nullsub/mproc/readme.md

MPROC is a cpu built out of 74xx logic-gates.
