nullsub/mproc/docs/stuff/1bitalu.gif

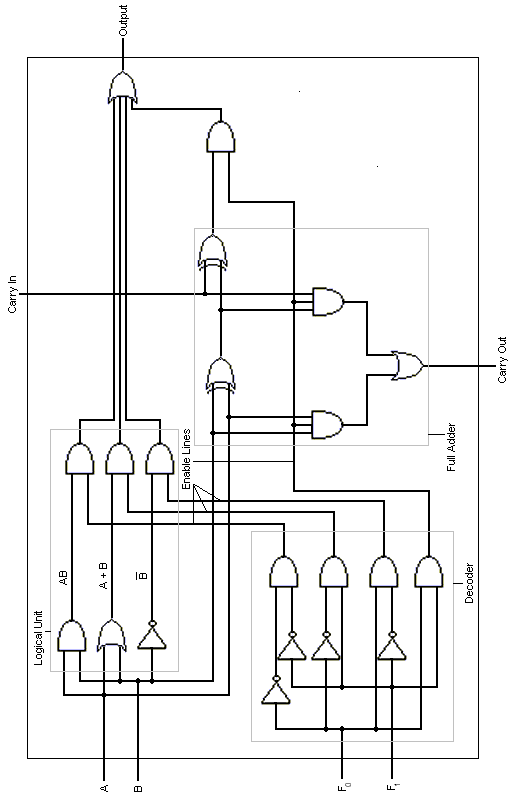
docs/stuff/1bitalu.gif
