nullsub/mproc/docs/stuff/Cse675.02.F.ALUDesign_part1.pdf

# Arithmetic / Logic Unit – ALU Design

### Presentation F

### CSE 675.02: Introduction to Computer Architecture

Reading Assignment: B5, 3.4 | Slides by Gojko Babi

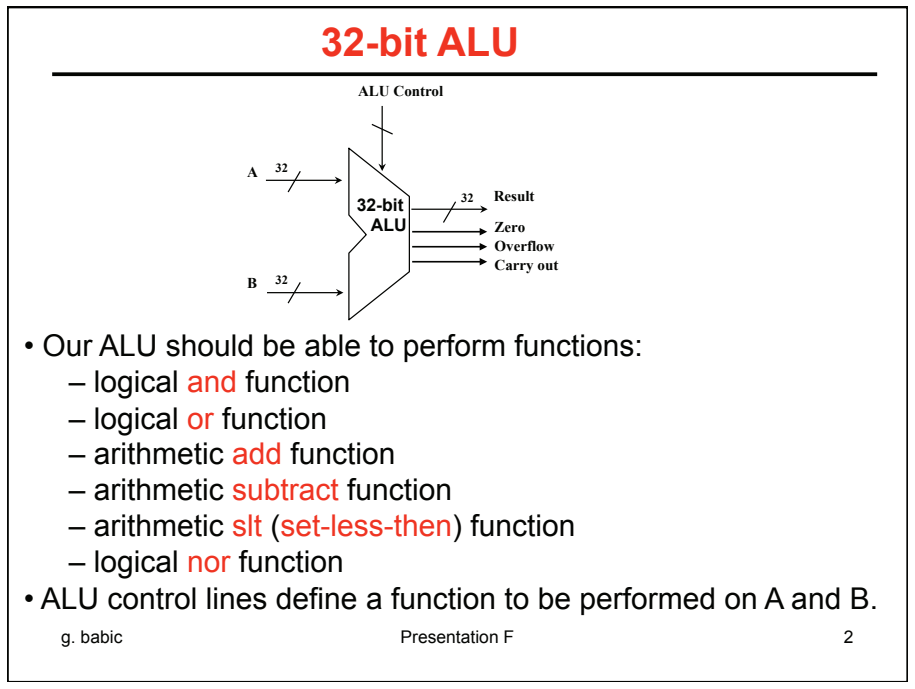
[picture p2: figure]
g. babic; Presentation F; ALU Control; 32 Result; 32-bit ALU; – logical and function – logical or function – arithmetic add function – arithmetic subtract function; – logical nor function; Zero Overflow Carry out

### - Our ALU should be able to perform functions:

### – arithmetic slt (set-less-then) function

- ALU control lines define a function to be performed on A and B.

g. babic | Presentation F | 3

## Functioning of 32-bit ALU

ALU Control

32

32

### 32 Result

A

B

32-bit
ALU | Zero
| Overflow Carry out

ALU Control lines

- Result lines provide result of the chosen function applied to values of A and B
- Since this ALU operates on 32-bit operands, it is called 32-bit ALU
- Zero output indicates if all Result lines have value 0
- Overflow indicates integer overflow of add and subtract functions;
for unsigned integers, this overflow indicator does not provide any useful information
- Carry out indicates carry out and unsigned integer overflow

4
Function | Ainvert | Binvert | Operation
and | 0 | 0 | 00
or | 0 | 0 | 01
add | 0 | 0 | 10
subtract | 0 | 1 | 10
slt | 0 | 1 | 11
nor | 1 | 1 | 00

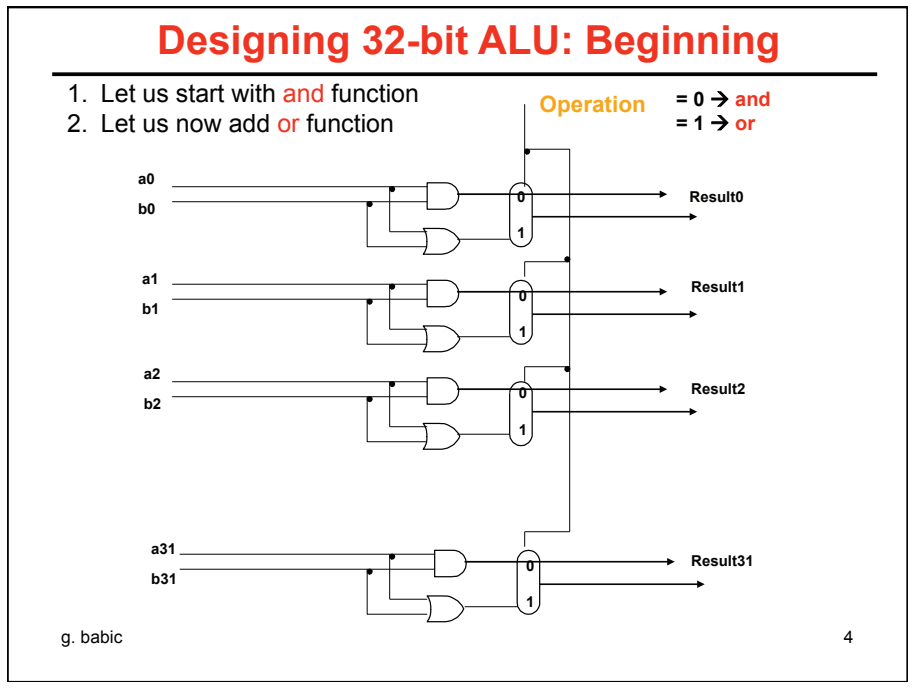
[picture p3: figure]
g. babic; Designing 32-bit ALU: Beginning; Result0; Result1; Result2; Result31; 1. Let us start with and function 2. Let us now add or function; Operation; and

## Designing 32-bit ALU: Principles

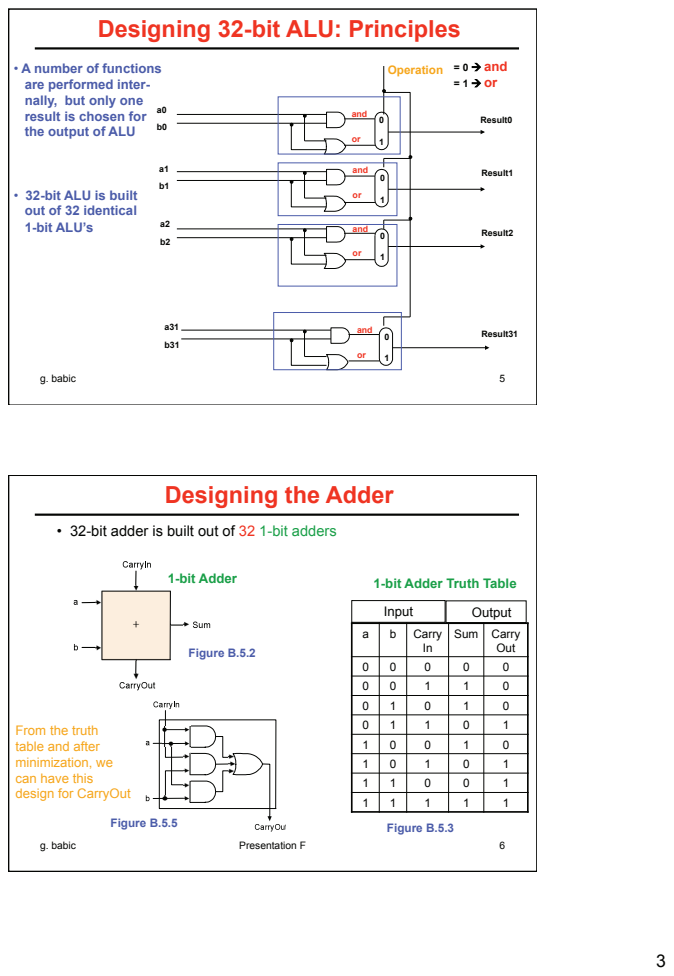
[picture p4: page 3]
g. babic; Result0; Result1; Result2; Result31; • A number of functions; Operation; and; Presentation F; Input; Output; Figure B.5.2; Figure B.5.5; Figure B.5.3

are performed inter-
nally, but only one
result is chosen for
the output of ALU

• 32-bit ALU is built
out of 32 identical
1-bit ALU’s

Designing the Adder

• 32-bit adder is built out of 32 1-bit adders

1-bit Adder Truth Table 1-bit Adder

a | b | Carry In | Sum | Carry Out

From the truth
table and after
minimization, we
can have this
design for CarryOut

## 32-bit Adder

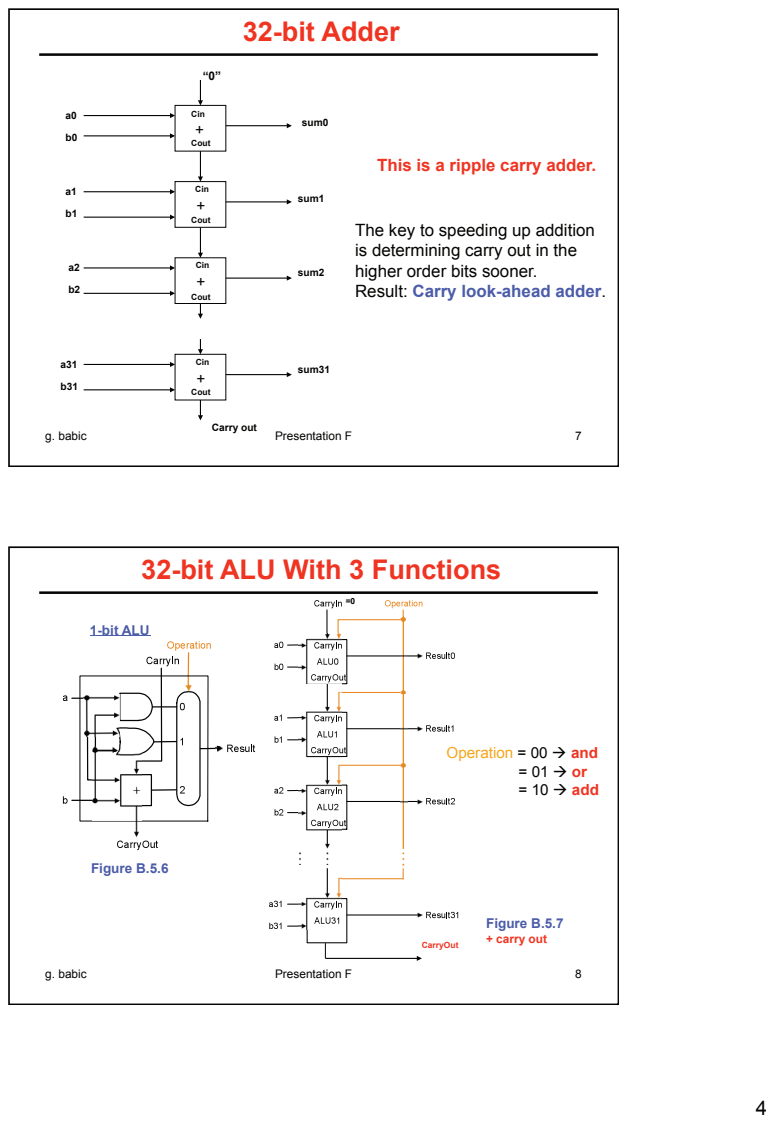
[picture p5: page 4]
g. babic; Presentation F; sum0; sum31; sum2; sum1; Cout; Cin; Carry out; 1-bit ALU; CarryOut; Operation = 00 -; and; add; Figure B.5.6; Figure B.5.7 + carry out

This is a ripple carry adder.

The key to speeding up addition
is determining carry out in the
higher order bits sooner.
Result: Carry look-ahead adder.

32-bit ALU With 3 Functions

## 32-bit Subtractor

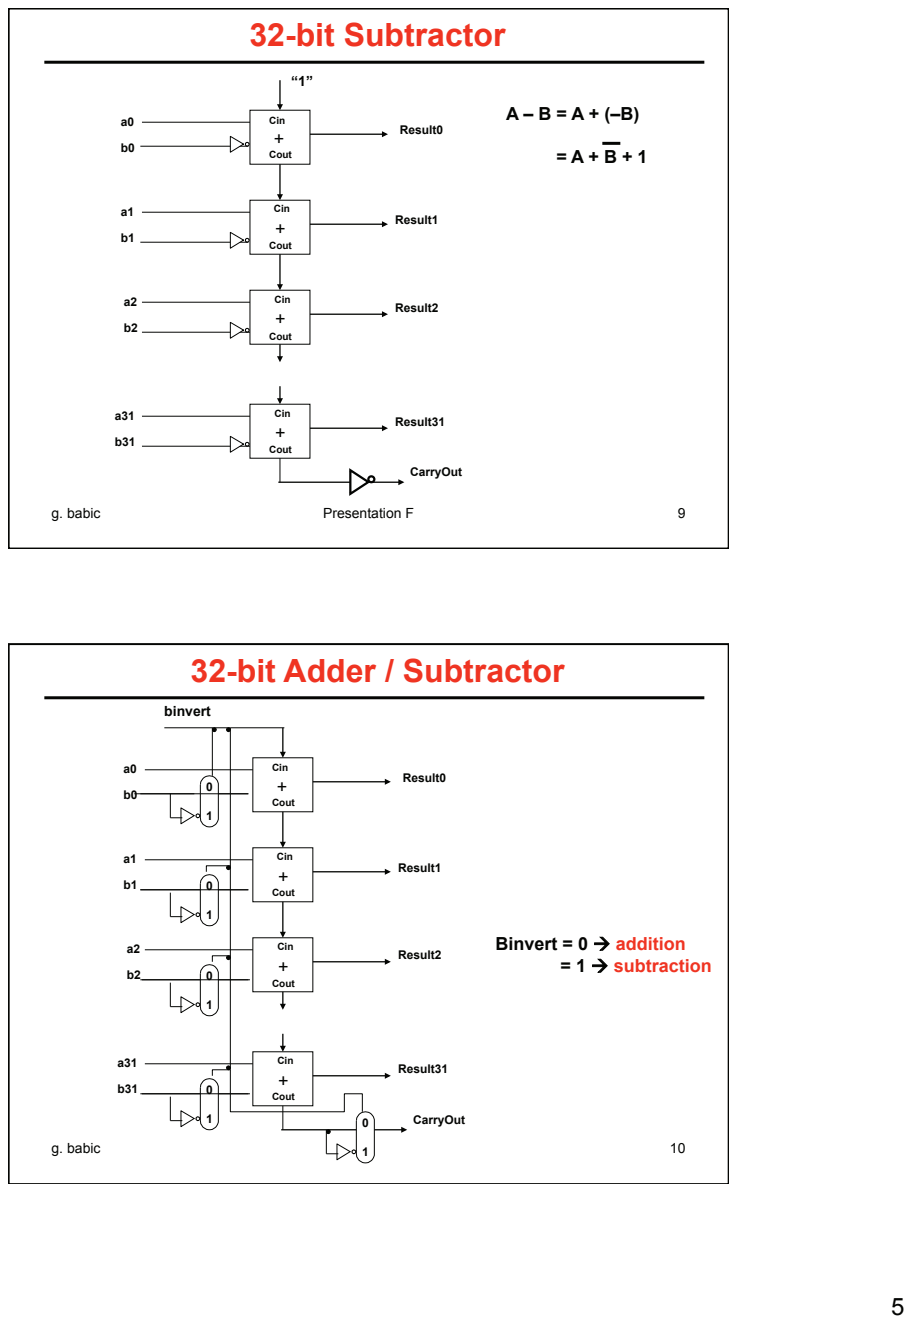
[picture p6: page 5]
g. babic; Presentation F; Result0; Result31; Result2; Result1; Cout; Cin; CarryOut; binvert; Binvert = 0 -; addition; subtraction

32-bit Adder / Subtractor

## 32-bit ALU With 4 Functions

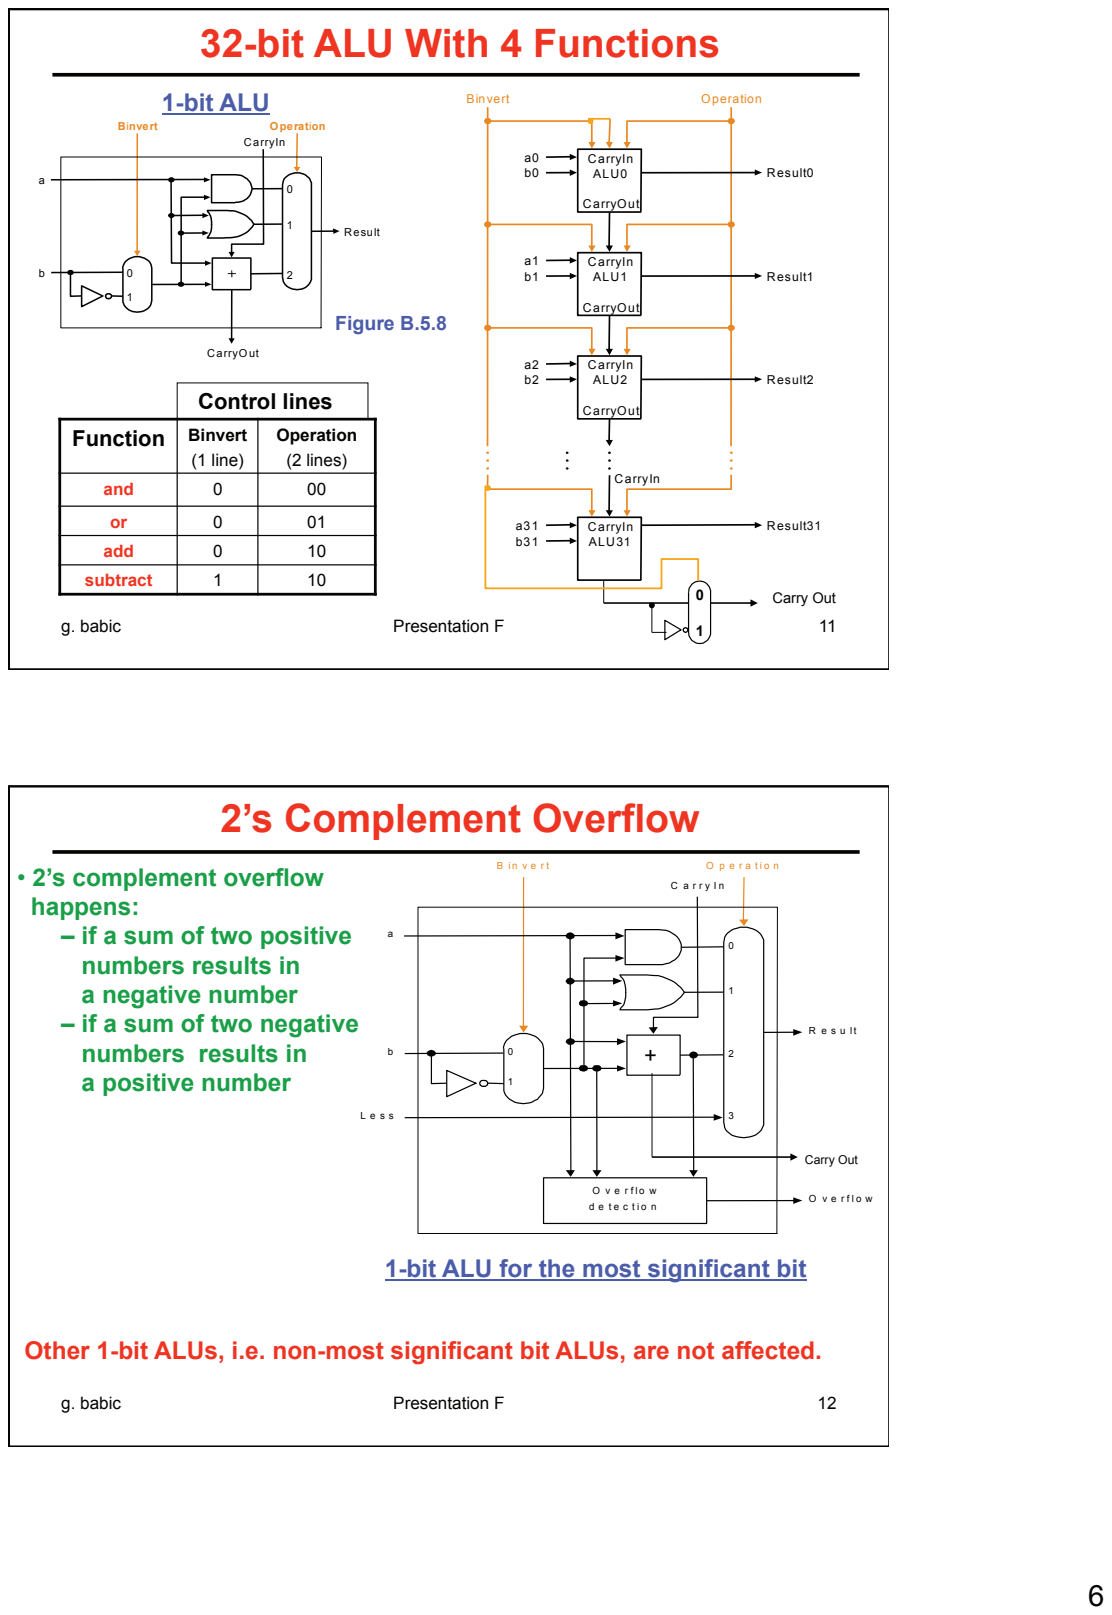
[picture p7: page 6]
g. babic; Presentation F; Control lines; 1-bit ALU; Carry Out; ALU0; Result0; Result1; Result2; Operation; Result31; Binvert; CarryIn; CarryOut; ALU1; ALU2; ALU31; Result; Figure B.5.8; 2’s Complement Overflow

Function | Binvert (1 line) | Operation (2 lines)

and | 0 | 00

or | 0 | 01
add | 0 | 10
subtract | 1 | 10

• 2’s complement overflow
happens:
– if a sum of two positive
numbers results in
a negative number
– if a sum of two negative
a positive number

1-bit ALU for the most significant bit

Other 1-bit ALUs, i.e. non-most significant bit ALUs, are not affected.

## 32-bit ALU With 4 Functions and Overflow

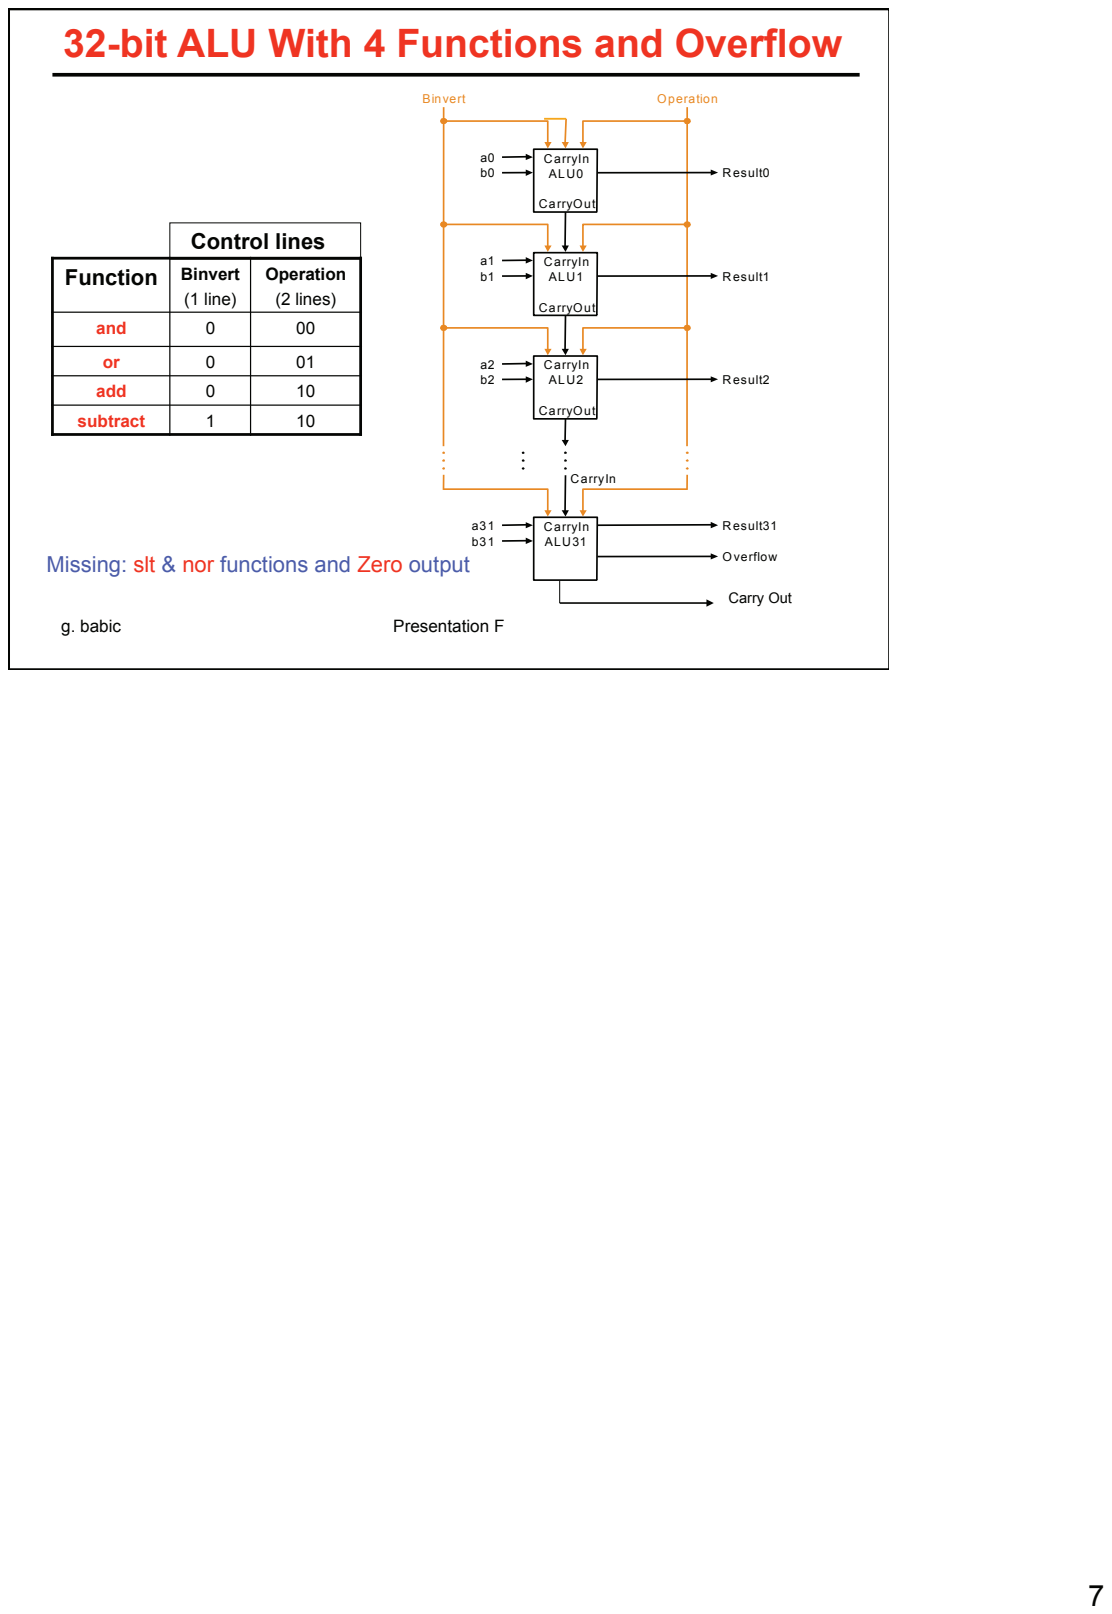
[picture p8: page 7]
g. babic; Presentation F; Carry Out; ALU0; Result0; Result1; Result2; Operation; Result31; Overflow; Binvert; CarryIn; CarryOut; ALU1; ALU2; ALU31; Control lines

Function | Binvert (1 line) | Operation (2 lines)

and | 0 | 00

or | 0 | 01
add | 0 | 10
subtract | 1 | 10

Missing: slt & nor functions and Zero output
