nullsub/mproc/schematics/IO_Board/io_board.brd

## EAGLE design schematics/IO_Board/io_board.brd (2019-09-12)

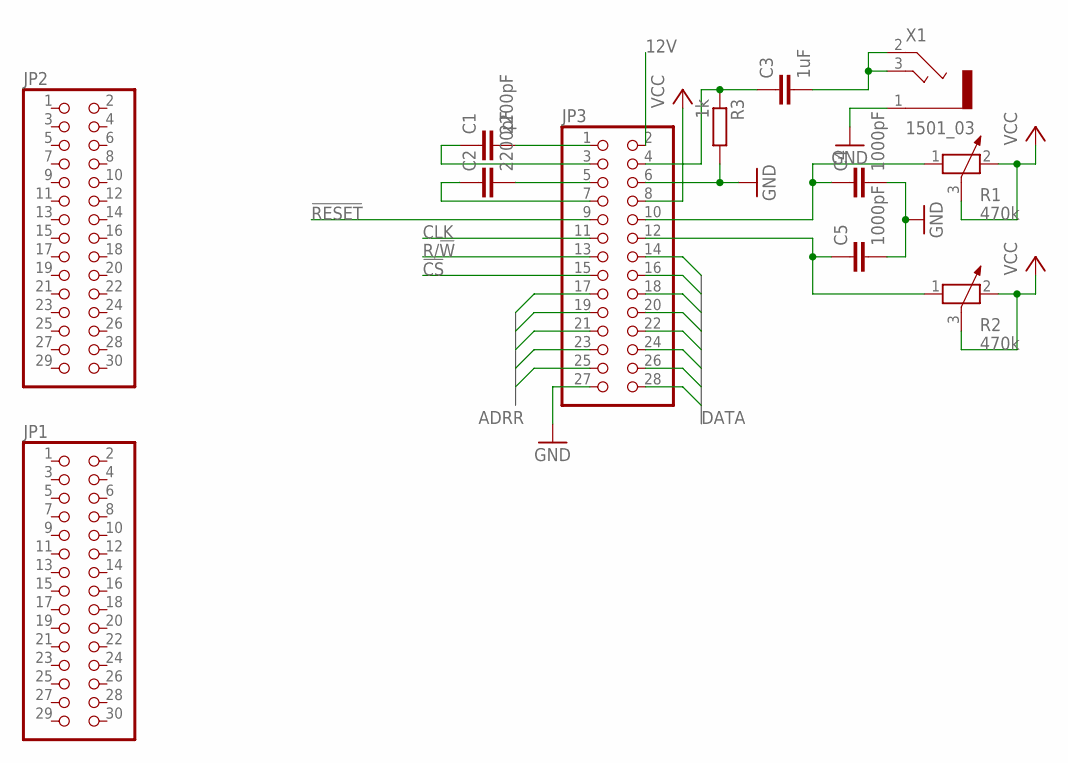
[picture p9: schematic io_board.sch]

Parts:
C1, C2: 2200pF; C1206
C3: 1uF; C1206
C4, C5: 1000pF; C1206
JP1, JP2: PINHD-2X15; 2X15
JP3: PINHD-2X14; 2X14
R1, R2: 470k; PT-10
R3: 1k; R0805
X1: 1501_03

Connections:
12V: JP3.2
!CS: JP3.15
!RESET: JP3.9
CLK: JP3.11
GND: C4.2, C5.2, JP3.6, JP3.27, R3.2, X1.1
unnamed: C4.1, JP3.10, R1.1
unnamed: C1.2, JP3.1
unnamed: C1.1, JP3.3
unnamed: C5.1, JP3.12, R2.1
unnamed: C2.2, JP3.5
unnamed: C2.1, JP3.7
unnamed: C3.2, X1.2, X1.3
unnamed: C3.1, JP3.4, R3.1
R/!W: JP3.13
VCC: JP3.8, R1.2, R1.3, R2.2, R2.3

Board: 2 copper layers, 12 parts (0 on the bottom side), 10 nets, no tracks yet.
