nullsub/mproc/schematics/UI_board/ui_board.brd

## EAGLE design schematics/UI_board/ui_board.brd (2014-05-11)

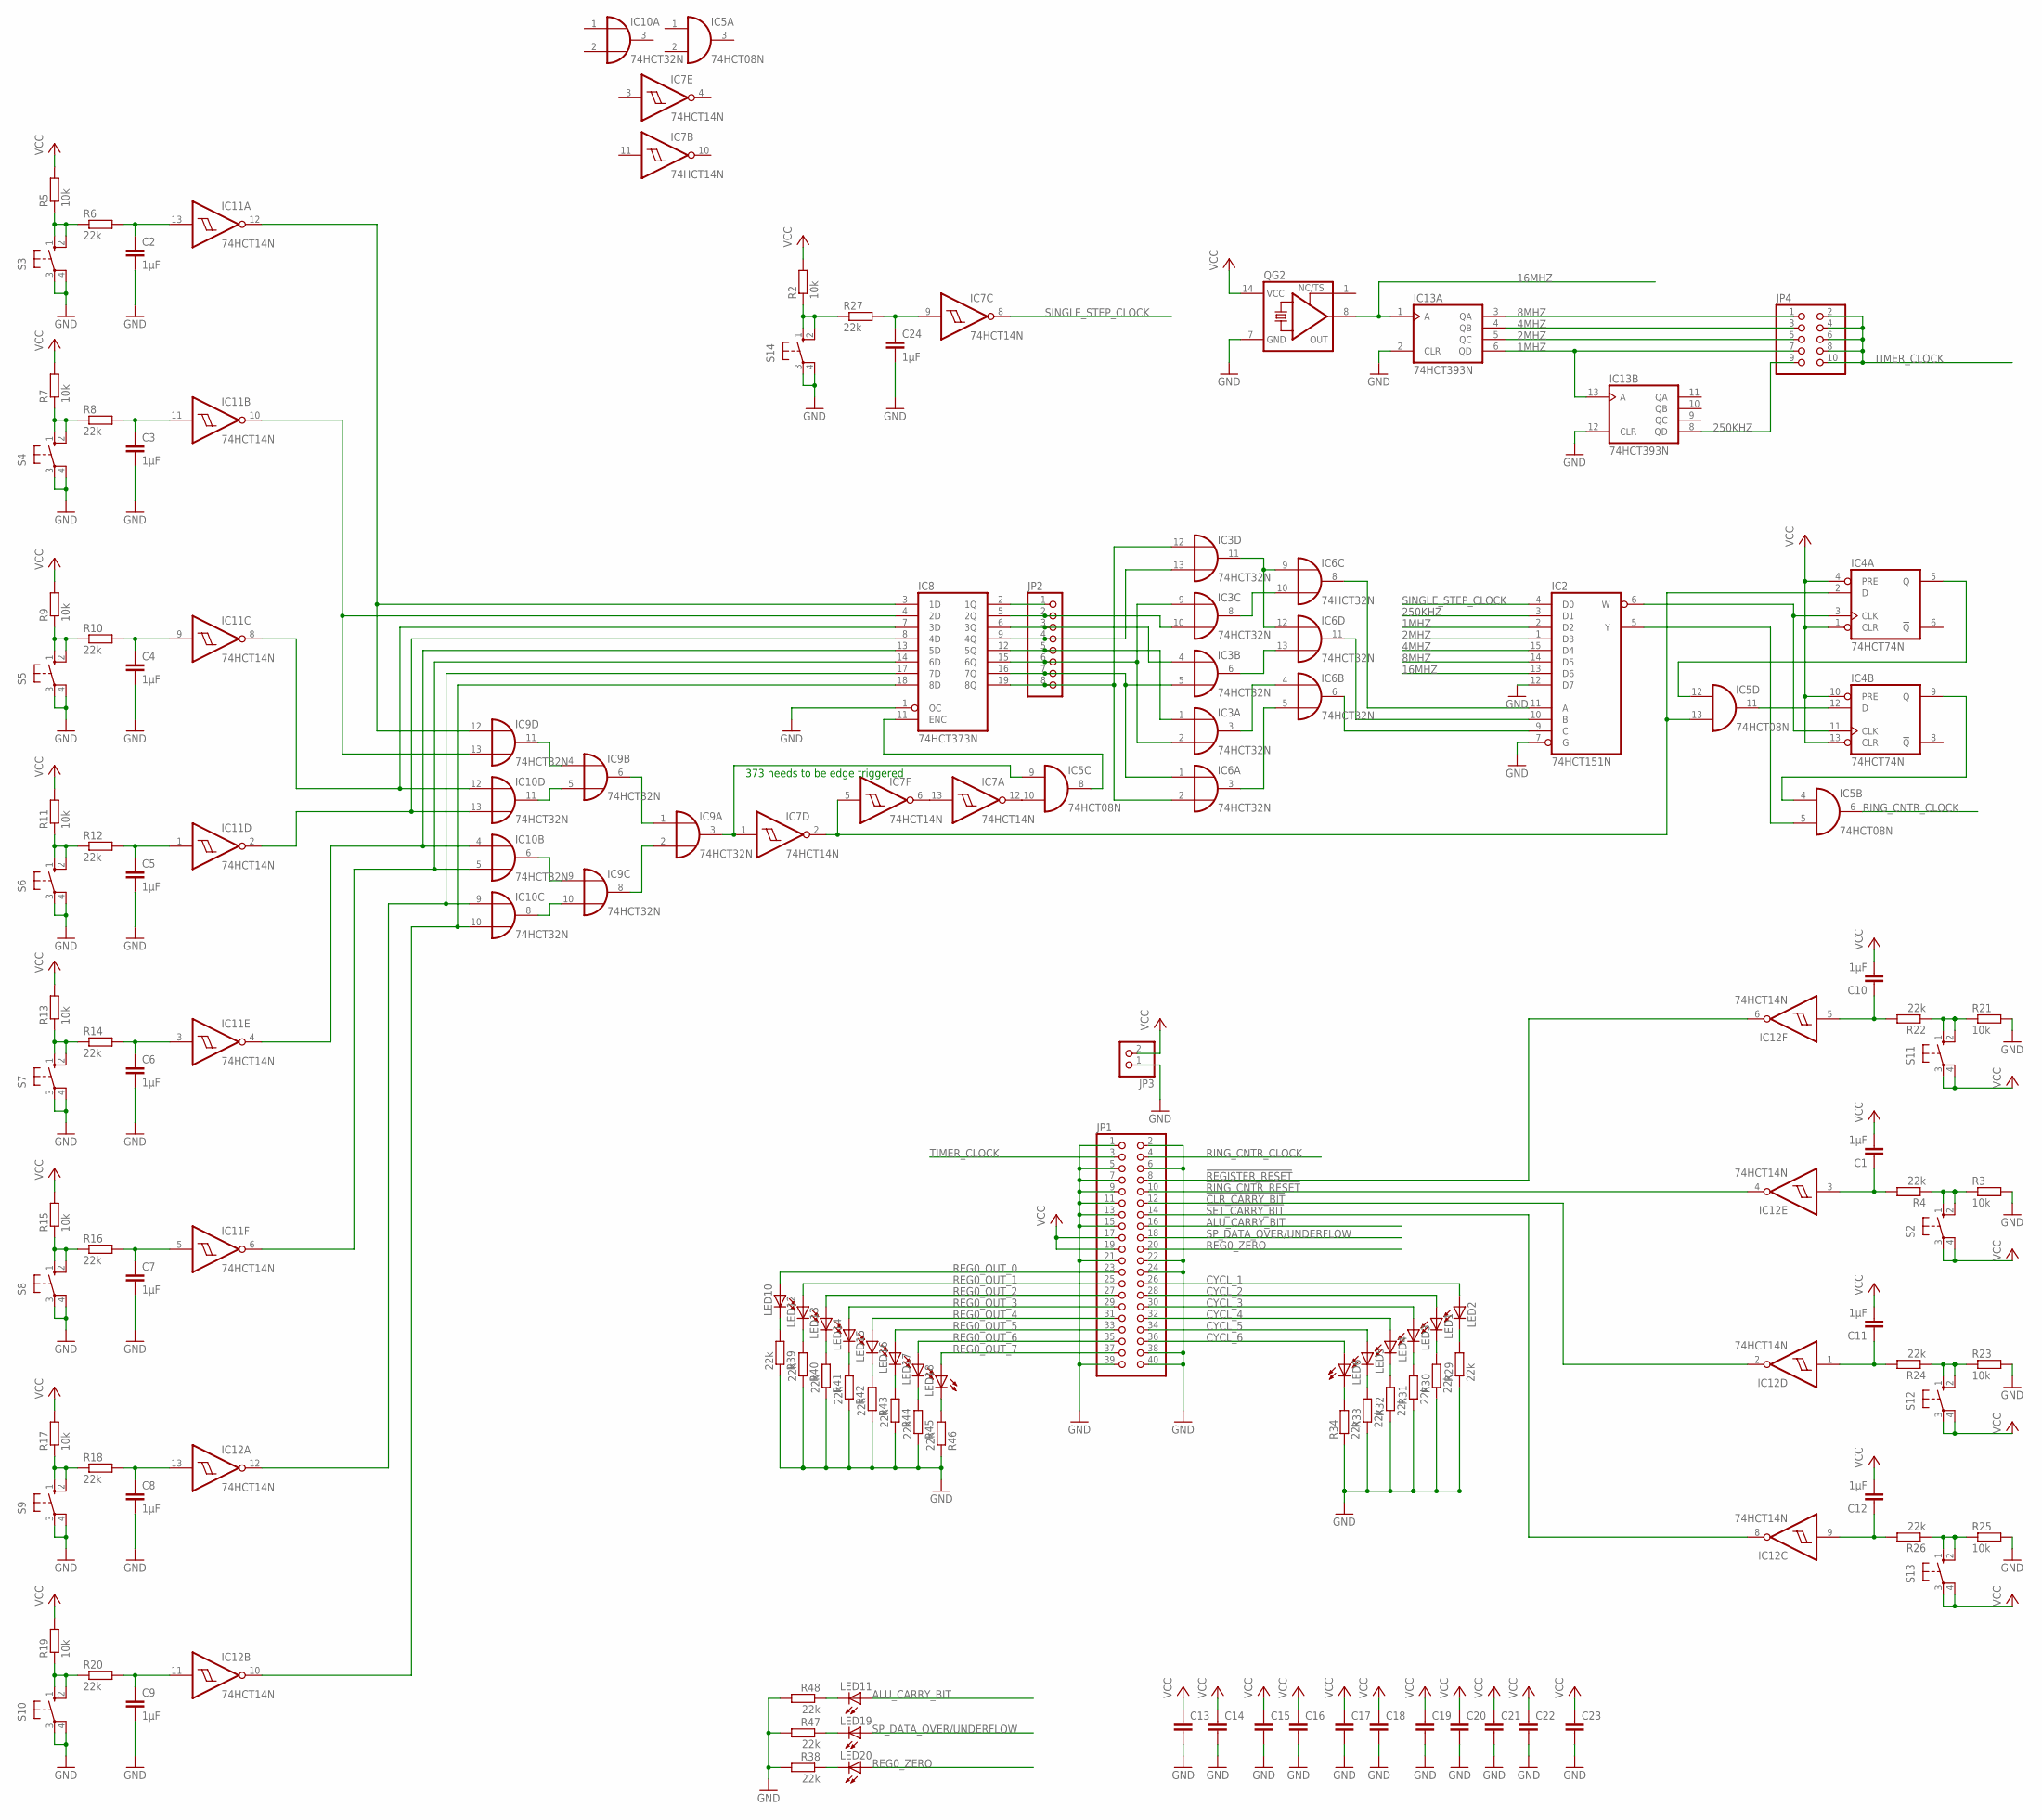
[picture p10: schematic ui_board.sch]

Parts:
C1, C2, C3, C4, C5, C6, C7, C8, C9, C10, C11, C12, C24: 1µF; C025-024X044
C13, C14, C15, C16, C17, C18, C19, C20, C21, C22, C23: C-EUC1206; C1206
IC2: 74HCT151N; DIL16
IC3, IC6, IC9, IC10: 74HCT32N; DIL14
IC4: 74HCT74N; DIL14
IC5: 74HCT08N; DIL14
IC7, IC11, IC12: 74HCT14N; DIL14
IC8: 74HCT373N; DIL20
IC13: 74HCT393N; DIL14
JP1: PINHD-2X20; 2X20
JP2: PINHD-1X8; 1X08
JP3: PINHD-1X2; 1X02
JP4: PINHD-2X5; 2X05
LED1, LED2, LED3, LED4, LED5, LED6, LED10, LED11, LED12, LED13, LED14, LED15, LED16, LED17, LED18, LED19, LED20: LED3MM
QG2: XO-14; DIL14S
R2, R3, R5, R7, R9, R11, R13, R15, R17, R19, R21, R23, R25: 10k; R1206
R4, R6, R8, R10, R12, R14, R16, R18, R20, R22, R24, R26, R27, R29, R30, R31, R32, R33, R34, R38, R39, R40, R41, R42, R43, R44, R45, R46, R47, R48: 22k; R1206
S2, S3, S4, S5, S6, S7, S8, S9, S10, S11, S12, S13, S14: 10-XX; B3F-10XX

Connections:
1MHZ: IC2.2 (D2), IC13.6 (QD), IC13.13 (A), JP4.7
2MHZ: IC2.1 (D3), IC13.5 (QC), JP4.5
4MHZ: IC2.15 (D4), IC13.4 (QB), JP4.3
8MHZ: IC2.14 (D5), IC13.3 (QA), JP4.1
16MHZ: IC2.13 (D6), IC13.1 (A), QG2.8 (OUT)
250KHZ: IC2.3 (D1), IC13.8 (QD), JP4.9
!CLR_CARRY_BIT: IC12.2 (O), JP1.12
!REGISTER_RESET: IC12.6 (O), JP1.8
!RING_CNTR_RESET: IC12.4 (O), JP1.10
!SET_CARRY_BIT: IC12.8 (O), JP1.14
ALU_CARRY_BIT: JP1.16, LED11.A
CHANGE_CLOCK_SELECT: IC5.9 (I0), IC7.1 (I), IC9.3 (O)
CHANGE_CLOCK_SELECT1: IC8.3 (1D), IC9.12 (I0), IC11.12 (O)
CHANGE_CLOCK_SELECT2: IC8.4 (2D), IC9.13 (I1), IC11.10 (O)
CHANGE_CLOCK_SELECT3: IC8.7 (3D), IC10.12 (I0), IC11.8 (O)
CHANGE_CLOCK_SELECT5: IC8.13 (5D), IC10.4 (I0), IC11.4 (O)
CHANGE_CLOCK_SELECT6: IC8.14 (6D), IC10.5 (I1), IC11.6 (O)
CHANGE_CLOCK_SELECT7: IC8.17 (7D), IC10.9 (I0), IC12.12 (O)
CHANGE_CLOCK_SELECT8: IC8.18 (8D), IC10.10 (I1), IC12.10 (O)
CYCL_1: JP1.26, LED2.A
CYCL_2: JP1.28, LED1.A
CYCL_3: JP1.30, LED3.A
CYCL_4: JP1.32, LED4.A
CYCL_5: JP1.34, LED5.A
CYCL_6: JP1.36, LED6.A
GND: C2.2, C3.2, C4.2, C5.2, C6.2, C7.2, C8.2, C9.2, C13.2, C14.2, C15.2, C16.2, C17.2, C18.2, C19.2, C20.2, C21.2, C22.2, C23.2, C24.2, IC2.7 (G), IC2.8 (GND), IC2.12 (D7), IC3.7 (GND), IC4.7 (GND), IC5.7 (GND), IC6.7 (GND), IC7.7 (GND), IC8.1 (OC), IC8.10 (GND), IC9.7 (GND), IC10.7 (GND), IC11.7 (GND), IC12.7 (GND), IC13.2 (CLR), IC13.7 (GND), IC13.12 (CLR), JP1.1, JP1.2, JP1.5, JP1.6, JP1.7, JP1.9, JP1.11, JP1.13, JP1.15, JP1.21, JP1.22, JP1.24, JP1.38, JP1.39, JP1.40, JP3.1, QG2.7 (GND), R3.2, R21.2, R23.2, R25.2, R29.1, R30.1, R31.1, R32.1, R33.1, R34.1, R38.2, R39.1, R40.1, R41.1, R42.1, R43.1, R44.1, R45.1, R46.1, R47.2, R48.2, S3.3, S3.4 (P1), S4.3, S4.4 (P1), S5.3, S5.4 (P1), S6.3, S6.4 (P1), S7.3, S7.4 (P1), S8.3, S8.4 (P1), S9.3, S9.4 (P1), S10.3, S10.4 (P1), S14.3, S14.4 (P1)
unnamed: IC4.9 (Q), IC5.4 (I0)
unnamed: R2.1, R27.1, S14.1 (S), S14.2 (S1)
unnamed: IC4.12 (D), IC5.11 (O)
unnamed: IC2.6 (W), IC4.3 (CLK), IC4.11 (CLK)
unnamed: IC2.10 (B), IC6.11 (O)
unnamed: IC8.2 (1Q), JP2.1
unnamed: IC4.5 (Q), IC5.12 (I0)
unnamed: IC7.6 (O), IC7.13 (I)
unnamed: IC4.2 (D), IC5.13 (I1), IC7.2 (O), IC7.5 (I)
unnamed: IC2.11 (A), IC6.8 (O)
unnamed: IC3.11 (O), IC6.9 (I0), IC6.12 (I0)
unnamed: IC2.9 (C), IC6.6 (O)
unnamed: R5.1, R6.1, S3.1 (S), S3.2 (S1)
unnamed: C2.1, IC11.13 (I), R6.2
unnamed: R7.1, R8.1, S4.1 (S), S4.2 (S1)
unnamed: LED20.K (C), R38.1
unnamed: IC3.6 (O), IC6.13 (I1)
unnamed: IC3.10 (I1), IC8.5 (2Q), JP2.2
unnamed: R3.1, R4.1, S2.1 (S), S2.2 (S1)
unnamed: IC3.13 (I1), IC8.9 (4Q), JP2.4
unnamed: IC3.1 (I0), IC8.12 (5Q), JP2.5
unnamed: IC3.2 (I1), IC3.9 (I0), IC8.15 (6Q), JP2.6
unnamed: IC3.5 (I1), IC6.1 (I0), IC8.16 (7Q), JP2.7
unnamed: IC3.12 (I0), IC6.2 (I1), IC8.19 (8Q), JP2.8
unnamed: IC9.5 (I1), IC10.11 (O)
unnamed: IC9.4 (I0), IC9.11 (O)
unnamed: IC9.9 (I0), IC10.6 (O)
unnamed: IC9.10 (I1), IC10.8 (O)
unnamed: IC9.2 (I1), IC9.8 (O)
unnamed: IC9.1 (I0), IC9.6 (O)
unnamed: IC3.8 (O), IC6.10 (I1)
unnamed: IC3.3 (O), IC6.4 (I0)
unnamed: IC6.3 (O), IC6.5 (I1)
unnamed: C3.1, IC11.11 (I), R8.2
unnamed: R9.1, R10.1, S5.1 (S), S5.2 (S1)
unnamed: C4.1, IC11.9 (I), R10.2
unnamed: R11.1, R12.1, S6.1 (S), S6.2 (S1)
unnamed: C5.1, IC11.1 (I), R12.2
unnamed: R13.1, R14.1, S7.1 (S), S7.2 (S1)
unnamed: C6.1, IC11.3 (I), R14.2
unnamed: R15.1, R16.1, S8.1 (S), S8.2 (S1)
unnamed: C7.1, IC11.5 (I), R16.2
unnamed: R17.1, R18.1, S9.1 (S), S9.2 (S1)
unnamed: C8.1, IC12.13 (I), R18.2
unnamed: R19.1, R20.1, S10.1 (S), S10.2 (S1)
unnamed: C9.1, IC12.11 (I), R20.2
unnamed: C1.1, IC12.3 (I), R4.2
unnamed: IC8.8 (4D), IC10.13 (I1), IC11.2 (O)
unnamed: R21.1, R22.1, S11.1 (S), S11.2 (S1)
unnamed: C10.1, IC12.5 (I), R22.2
unnamed: R23.1, R24.1, S12.1 (S), S12.2 (S1)
unnamed: C11.1, IC12.1 (I), R24.2
unnamed: R25.1, R26.1, S13.1 (S), S13.2 (S1)
unnamed: C12.1, IC12.9 (I), R26.2
unnamed: C24.1, IC7.9 (I), R27.2
unnamed: LED10.K (C), R39.2
unnamed: LED12.K (C), R40.2
unnamed: LED13.K (C), R41.2
unnamed: LED2.K (C), R29.2
unnamed: LED1.K (C), R30.2
unnamed: LED3.K (C), R31.2
unnamed: LED4.K (C), R32.2
unnamed: LED5.K (C), R33.2
unnamed: LED6.K (C), R34.2
unnamed: IC5.10 (I1), IC7.12 (O)
unnamed: LED14.K (C), R42.2
unnamed: LED15.K (C), R43.2
unnamed: LED16.K (C), R44.2
unnamed: LED17.K (C), R45.2
unnamed: LED18.K (C), R46.2
unnamed: LED19.K (C), R47.1
unnamed: LED11.K (C), R48.1
unnamed: IC3.4 (I0), IC8.6 (3Q), JP2.3
unnamed: IC5.8 (O), IC8.11 (ENC)
REG0_OUT_0: JP1.23, LED10.A
REG0_OUT_1: JP1.25, LED12.A
REG0_OUT_2: JP1.27, LED13.A
REG0_OUT_3: JP1.29, LED14.A
REG0_OUT_4: JP1.31, LED15.A
REG0_OUT_5: JP1.33, LED16.A
REG0_OUT_6: JP1.35, LED17.A
REG0_OUT_7: JP1.37, LED18.A
REG0_ZERO: JP1.20, LED20.A
RING_CNTR_CLOCK: IC5.6 (O), JP1.4
SELECTED_CLOCK: IC2.5 (Y), IC5.5 (I1)
SINGLE_STEP_CLOCK: IC2.4 (D0), IC7.8 (O)
SP_DATA_OVER/UNDERFLOW: JP1.18, LED19.A
TIMER_CLOCK: JP1.3, JP4.2, JP4.4, JP4.6, JP4.8, JP4.10
VCC: C1.2, C10.2, C11.2, C12.2, C13.1, C14.1, C15.1, C16.1, C17.1, C18.1, C19.1, C20.1, C21.1, C22.1, C23.1, IC2.16 (VCC), IC3.14 (VCC), IC4.1 (CLR), IC4.4 (PRE), IC4.10 (PRE), IC4.13 (CLR), IC4.14 (VCC), IC5.14 (VCC), IC6.14 (VCC), IC7.14 (VCC), IC8.20 (VCC), IC9.14 (VCC), IC10.14 (VCC), IC11.14 (VCC), IC12.14 (VCC), IC13.14 (VCC), JP1.17, JP1.19, JP3.2, QG2.14 (VCC), R2.2, R5.2, R7.2, R9.2, R11.2, R13.2, R15.2, R17.2, R19.2, S2.3, S2.4 (P1), S11.3, S11.4 (P1), S12.3, S12.4 (P1), S13.3, S13.4 (P1)

Notes on the sheet:
373 needs to be edge triggered

Board: 2 copper layers, 114 parts (42 on the bottom side), 115 nets, no tracks yet.
