nullsub/mproc/schematics/ALU/ALU.brd

## EAGLE design schematics/ALU/ALU.brd (2013-09-06)

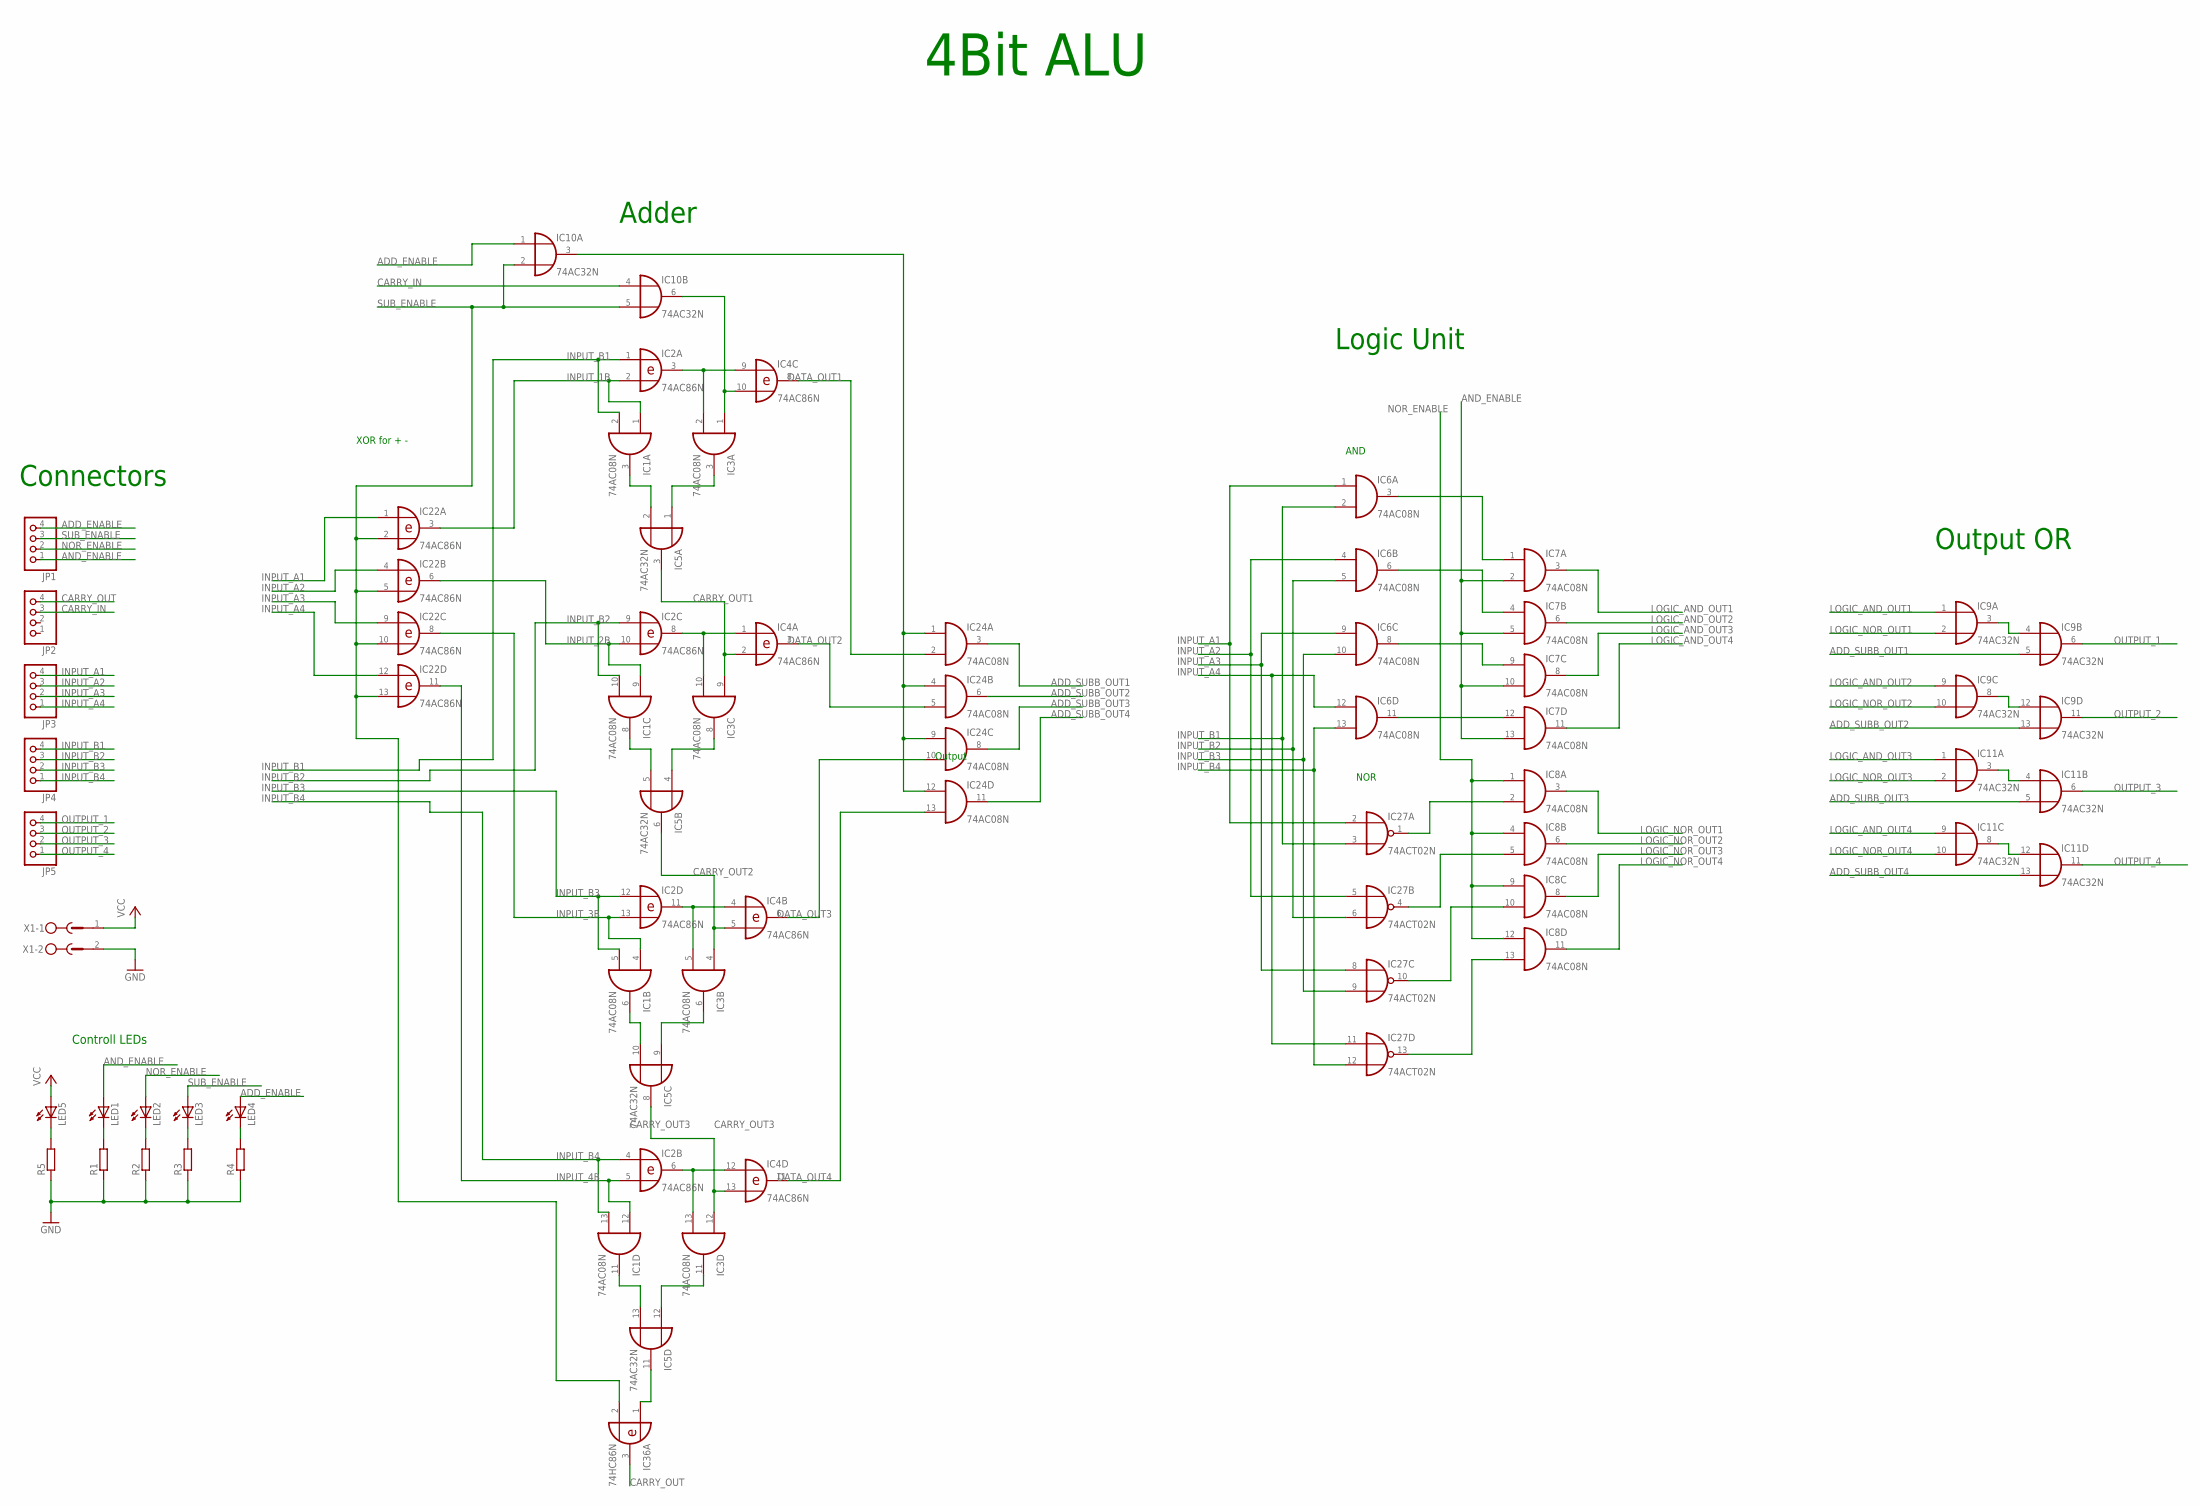
[picture p11: schematic ALU.sch]

Parts:
IC1, IC3, IC6, IC7, IC8, IC24: 74AC08N; DIL14
IC2, IC4, IC22: 74AC86N; DIL14
IC5, IC9, IC10, IC11: 74AC32N; DIL14
IC27: 74ACT02N; DIL14
IC36: 74HC86N; DIL14
JP1, JP2, JP3, JP4, JP5: PINHD-1X4; 1X04
LED1, LED2, LED3, LED4, LED5: LED5MM
R1, R2, R3, R4, R5: R-EU_0204/5; 0204/5
X1: MSTBV2

Connections:
ADD_ENABLE: IC10.1 (I0), JP1.4, LED4.A
ADD_SUBB_OUT1: IC9.5 (I1), IC24.3 (O)
ADD_SUBB_OUT2: IC9.13 (I1), IC24.6 (O)
ADD_SUBB_OUT3: IC11.5 (I1), IC24.8 (O)
ADD_SUBB_OUT4: IC11.13 (I1), IC24.11 (O)
ADD_SUB_ENABLE: IC10.3 (O), IC24.1 (I0), IC24.4 (I0), IC24.9 (I0), IC24.12 (I0)
AND_ENABLE: IC7.2 (I1), IC7.5 (I1), IC7.10 (I1), IC7.13 (I1), JP1.1, LED1.A
CARRY_IN: IC10.4 (I0), JP2.3
CARRY_OUT: IC36.3 (O), JP2.4
CARRY_OUT1: IC3.9 (I0), IC4.2 (I1), IC5.3 (O)
CARRY_OUT2: IC3.4 (I0), IC4.5 (I1), IC5.6 (O)
CARRY_OUT3: IC3.12 (I0), IC4.13 (I1), IC5.8 (O)
DATA_OUT1: IC4.8 (O), IC24.2 (I1)
DATA_OUT2: IC4.3 (O), IC24.5 (I1)
DATA_OUT3: IC4.6 (O), IC24.10 (I1)
DATA_OUT4: IC4.11 (O), IC24.13 (I1)
GND: IC1.7 (GND), IC2.7 (GND), IC3.7 (GND), IC4.7 (GND), IC5.7 (GND), IC6.7 (GND), IC7.7 (GND), IC8.7 (GND), IC9.7 (GND), IC10.7 (GND), IC11.7 (GND), IC22.7 (GND), IC24.7 (GND), IC27.7 (GND), IC36.7 (GND), R1.1, R2.1, R3.1, R4.1, R5.1, X1.2
INPUT_1B: IC1.1 (I0), IC2.2 (I1), IC22.3 (O)
INPUT_2B: IC1.9 (I0), IC2.10 (I1), IC22.6 (O)
INPUT_3B: IC1.4 (I0), IC2.13 (I1), IC22.8 (O)
INPUT_4B: IC1.12 (I0), IC2.5 (I1), IC22.11 (O)
INPUT_A1: IC6.1 (I0), IC22.1 (I0), IC27.2 (I0), JP3.4
INPUT_A2: IC6.4 (I0), IC22.4 (I0), IC27.5 (I0), JP3.3
INPUT_A3: IC6.9 (I0), IC22.9 (I0), IC27.8 (I0), JP3.2
INPUT_A4: IC6.12 (I0), IC22.12 (I0), IC27.11 (I0), JP3.1
INPUT_B1: IC1.2 (I1), IC2.1 (I0), IC6.2 (I1), IC27.3 (I1), JP4.4
INPUT_B2: IC1.10 (I1), IC2.9 (I0), IC6.5 (I1), IC27.6 (I1), JP4.3
INPUT_B3: IC1.5 (I1), IC2.12 (I0), IC6.10 (I1), IC27.9 (I1), JP4.2
INPUT_B4: IC1.13 (I1), IC2.4 (I0), IC6.13 (I1), IC27.12 (I1), JP4.1
LOGIC_AND_OUT1: IC7.3 (O), IC9.1 (I0)
LOGIC_AND_OUT2: IC7.6 (O), IC9.9 (I0)
LOGIC_AND_OUT3: IC7.8 (O), IC11.1 (I0)
LOGIC_AND_OUT4: IC7.11 (O), IC11.9 (I0)
LOGIC_NOR_OUT1: IC8.3 (O), IC9.2 (I1)
LOGIC_NOR_OUT2: IC8.6 (O), IC9.10 (I1)
LOGIC_NOR_OUT3: IC8.8 (O), IC11.2 (I1)
LOGIC_NOR_OUT4: IC8.11 (O), IC11.10 (I1)
unnamed: IC1.3 (O), IC5.2 (I1)
unnamed: IC3.3 (O), IC5.1 (I0)
unnamed: IC2.3 (O), IC3.2 (I1), IC4.9 (I0)
unnamed: IC3.8 (O), IC5.4 (I0)
unnamed: IC1.8 (O), IC5.5 (I1)
unnamed: IC2.8 (O), IC3.10 (I1), IC4.1 (I0)
unnamed: IC3.6 (O), IC5.9 (I0)
unnamed: IC1.6 (O), IC5.10 (I1)
unnamed: IC2.11 (O), IC3.5 (I1), IC4.4 (I0)
unnamed: IC3.11 (O), IC5.12 (I0)
unnamed: IC1.11 (O), IC5.13 (I1)
unnamed: IC2.6 (O), IC3.13 (I1), IC4.12 (I0)
unnamed: IC9.3 (O), IC9.4 (I0)
unnamed: IC9.8 (O), IC9.12 (I0)
unnamed: IC11.3 (O), IC11.4 (I0)
unnamed: IC11.8 (O), IC11.12 (I0)
unnamed: LED1.K (C), R1.2
unnamed: LED2.K (C), R2.2
unnamed: IC6.6 (O), IC7.4 (I0)
unnamed: IC6.8 (O), IC7.9 (I0)
unnamed: IC6.3 (O), IC7.1 (I0)
unnamed: IC6.11 (O), IC7.12 (I0)
unnamed: LED3.K (C), R3.2
unnamed: IC8.5 (I1), IC27.4 (O)
unnamed: IC8.10 (I1), IC27.10 (O)
unnamed: IC8.13 (I1), IC27.13 (O)
unnamed: IC8.2 (I1), IC27.1 (O)
unnamed: LED4.K (C), R4.2
unnamed: LED5.K (C), R5.2
unnamed: IC3.1 (I0), IC4.10 (I1), IC10.6 (O)
NOR_ENABLE: IC8.1 (I0), IC8.4 (I0), IC8.9 (I0), IC8.12 (I0), JP1.2, LED2.A
OUTPUT_1: IC9.6 (O), JP5.4
OUTPUT_2: IC9.11 (O), JP5.3
OUTPUT_3: IC11.6 (O), JP5.2
OUTPUT_4: IC11.11 (O), JP5.1
SUB_ENABLE: IC10.2 (I1), IC10.5 (I1), IC22.2 (I1), IC22.5 (I1), IC22.10 (I1), IC22.13 (I1), IC36.2 (I1), JP1.3, LED3.A
VCC: IC1.14 (VCC), IC2.14 (VCC), IC3.14 (VCC), IC4.14 (VCC), IC5.14 (VCC), IC6.14 (VCC), IC7.14 (VCC), IC8.14 (VCC), IC9.14 (VCC), IC10.14 (VCC), IC11.14 (VCC), IC22.14 (VCC), IC24.14 (VCC), IC27.14 (VCC), IC36.14 (VCC), LED5.A, X1.1
______________: IC5.11 (O), IC36.1 (I0)

Notes on the sheet:
Output
Adder
Logic Unit
AND
NOR
4Bit ALU
Output OR
Connectors
XOR for + -
Controll LEDs

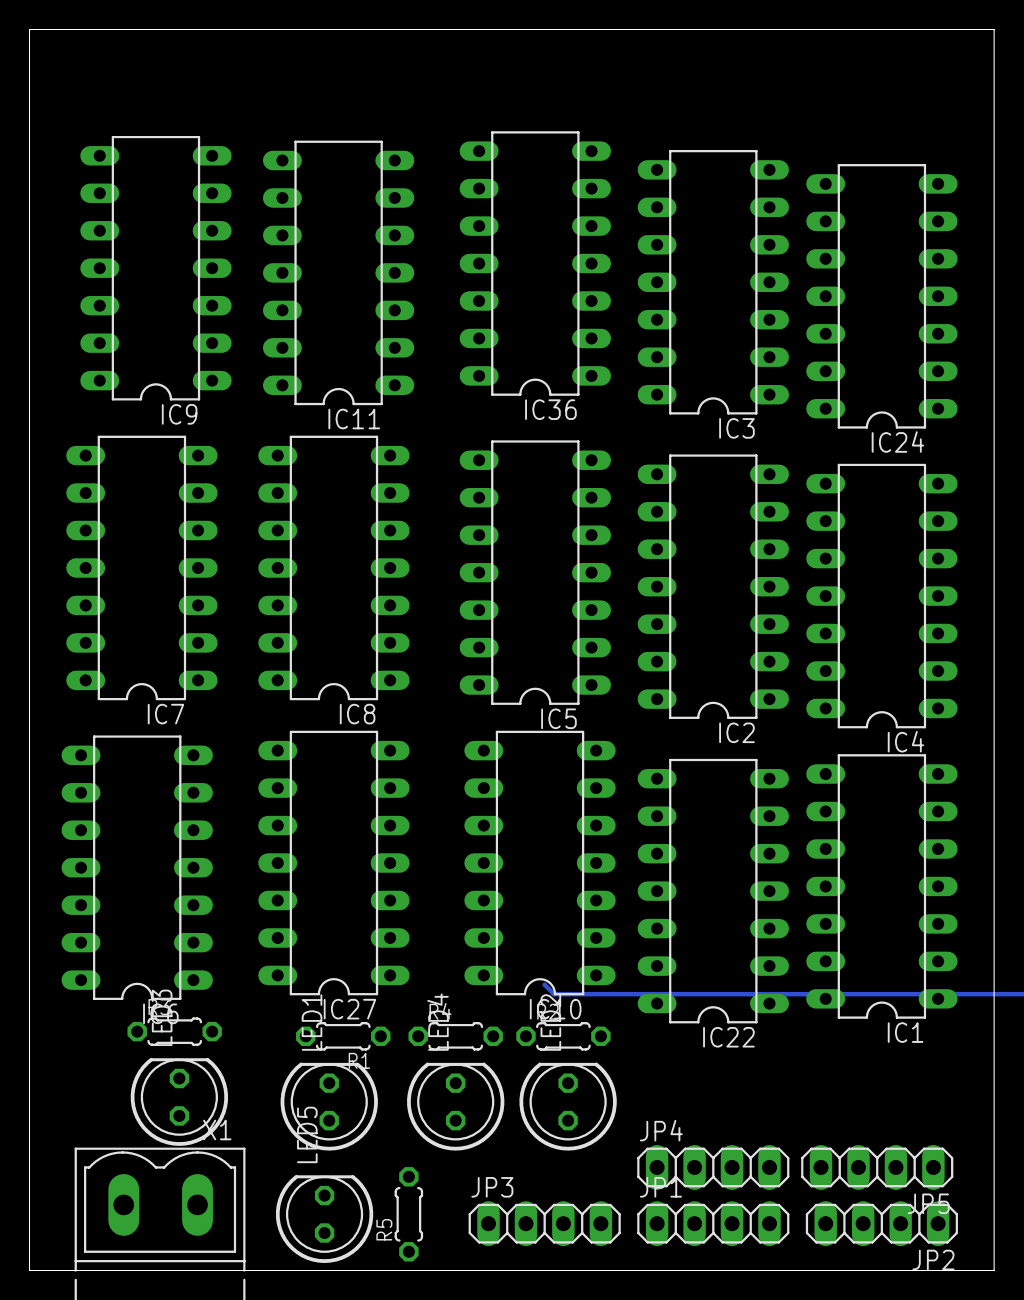
[picture p12: board ALU.brd from above]

Board: 2 copper layers, 65.4 x 84.1 mm, 31 parts (0 on the bottom side), 75 nets.
