nullsub/mproc/(commit log)

2012-09-13 changed the ISA(rm MOVC..). Implemented changes in assembler and emulator
2012-09-13 cleaned up assembler.c
2012-09-13 added schematics
    [ALU.brd, ALU.sch, Control_Unit.sch]
2012-09-13 changed dr to br. Bankregister sounds better than Dateregister.
    [Control_Unit.sch]
2012-09-13 fixed define BUG: only one define was saved - added some memory management.
    [assembler.c]
2013-01-25 fixed LOW() and HIGH() bug. It was not working for normal base-10 integers
    [assembler.c, emulator.c, test.asm]
2013-01-26 reimplemented the opcode decoder.
    Still lots to be done
    [Control_Unit.sch]
2013-01-26 changed JMP instruction. Use direct-immediate instead of offset operands
    This is easier to implement both in the compiler and in hardware since no 16-bit addition has to be done
    [Control_Unit.sch]
2013-01-28 fixed operand decoder table. Use binary counter chip for the SP and PC.
    Lots of small changes.
    [Control_Unit.sch]
2013-01-31 Finished opcode decoder. Changed ISA
    Changed STR and LDA instruction.
    Added new COUNT_BR instruction.
    COUNT_BR is not yet added to the assembler/emulator
    [Control_Unit.sch]
2013-01-31 finalized design. I do not think I will change the instructions much more
    [Control_Unit.sch]
2013-01-31 implement the design changes in the emulator and assembler
2013-01-31 Add I/O registers. Plus some small optimizations
    [Control_Unit.sch]
2013-01-31 fix part-numbering. Created Board File - a bit large
    [Control_Unit.brd, Control_Unit.sch]
2013-02-08 scale down the *brd. started the layout
    [Control_Unit.brd, Control_Unit.sch]
2013-02-09 converted the mproc manual to LaTeX. Moved some files around.
    [Control_Unit.brd]
2013-07-10 improve arch-design:
    rename BR register to PTR,
    rename COUNT_BR to PTR_ADD
    allow ofsets for PTR_ADD
    [Control_Unit.sch]
2013-07-13 fix JMP(C/Z) bug. works
    [assembler.c, emulator.c, test.asm]
2013-08-10 fix comparison bug. compare pointer not content!
    [emulator.c]
2013-08-10 switch JMP arguments. JMP regA, regB equals to pc_high = regA, pc_low = regB
2013-08-12 fix math test. now 16bit add and subtract work
    [math.asm]
2013-08-12 implement SET_PTR instruction
    [Control_Unit.brd, Control_Unit.sch]
2013-08-14 schematic: implemented JMP offset instruction.
    [Control_Unit.brd, Control_Unit.sch]
2013-08-15 implement PTR_ADD instruction. All instruction are now implemented!
    [Control_Unit.brd, Control_Unit.sch]
2013-08-15 clean up schematic. next up is Instruction fetch & decode
    [Control_Unit.brd, Control_Unit.sch]
2013-08-16 add fetch cycle
    [Control_Unit.brd, Control_Unit.sch]
2013-08-23 fix offset commands JMP and ADD_PTR
    [Control_Unit.brd, Control_Unit.sch]
2013-08-25 add second byte load of instruction fetch.
    [Control_Unit.brd, Control_Unit.sch]
2013-08-26 reorder arguments. decoding is now easier
    [Control_Unit.brd, Control_Unit.sch]
2013-08-26 add two byte cmd decoder
    [Control_Unit.brd, Control_Unit.sch]
2013-08-30 implement SAVE_LR/RET structure. LR register needs to be added.
    [Control_Unit.brd, Control_Unit.sch]
2013-09-02 add LR register. All instructions are now implemented.
    [Control_Unit.brd, Control_Unit.sch]
2013-09-04 finish ringcounter
    [Control_Unit.brd, Control_Unit.sch]
2013-09-04 add led library
    [Control_Unit.brd]
2013-09-06 add proper connectors
    [Control_Unit.brd, Control_Unit.sch]
2013-09-06 remove leds. I will make a interface board with them
    [ALU.brd, ALU.sch, Control_Unit.brd, Control_Unit.sch]
2013-09-11 add capacitors. Needs still some more..
    [Control_Unit.brd, Control_Unit.sch]
2013-09-12 add fanout comment.
    [Control_Unit.brd, Control_Unit.sch]
2013-09-13 routing: it now fits on a 200x200mm board
    [Control_Unit.brd, Control_Unit.sch]
2013-09-13 add nor gate to save space
    [Control_Unit.brd, Control_Unit.sch]
2013-09-15 add dsn file for autorouting
    [Control_Unit.brd, Control_Unit.dsn]
2013-09-15 make brd file smaller
    [Control_Unit.brd]
2013-09-15 optimize component count
    [Control_Unit.brd, Control_Unit.sch]
2013-09-16 remove 2 more chips
    [Control_Unit.brd, Control_Unit.sch]
2013-09-16 add UI board schematic
    [Control_Unit.brd, Control_Unit.sch, ui_board.brd, ui_board.sch]
2013-09-20 changed register chips to 74xx374
    [Control_Unit.brd, Control_Unit.dsn, Control_Unit.sch, ui_board.brd, ui_board.sch]
2013-09-21 forgot it
    [Control_Unit.brd, Control_Unit.sch]
2013-10-01 optimize chip count :)
    [Control_Unit.brd, Control_Unit.sch]
2013-10-02 start routing
    [Control_Unit.brd, Control_Unit.sch]
2013-10-03 start ui board layout
    [Control_Unit.dsn, ui_board.brd, ui_board.sch]
2013-10-06 fix. gonna try to reduce cycles to 8 per instruction now
    [Control_Unit.brd, Control_Unit.sch, ui_board.brd, ui_board.sch]
2013-10-07 got rid of two cycles! finetuning next
    [Control_Unit.brd, Control_Unit.sch, ui_board.brd, ui_board.sch]
2013-10-20 soldered ui bord
    [ui_board.brd, ui_board.sch]
2014-01-08 clean up docs and schematic. no functional changes
    [Control_Unit.brd, Control_Unit.sch, ui_board.sch]
2014-01-08 add run_tests for assembler
2014-01-24 fix ui_bord. seems to work
    [Control_Unit.sch, ui_board.brd, ui_board.sch]
2014-01-25 finished and tested ui-board.
    I Didnt check all clocks. 16Mhz, 4Mhz and the single_clock work
    [ui_board.brd, ui_board.sch]
2014-01-25 finished COntrolUnit. Not much left to do
    [Control_Unit.brd, Control_Unit.sch]
2014-01-30 improve layout
    [Control_Unit.brd, Control_Unit.sch]
2014-03-10 fix latex docs
    [ALU.sch, Control_Unit.brd, Control_Unit.sch, ui_board.brd, ui_board.sch]
2014-04-15 renumber schematic parts
    [Control_Unit.brd, Control_Unit.sch]
2014-04-25 fix WRITE_TO_DBUS signal
    [Control_Unit.brd, Control_Unit.sch]
2014-04-26 optimize part count
    [Control_Unit.brd, Control_Unit.sch]
2014-04-27 add STR and LDR varianst with auto-postincrement.
    remove PTR_ADD instruction. usually increment by 1 is enough for most needs.
    [Control_Unit.brd, Control_Unit.sch]
2014-05-11 feature freeze. I will now solder the Control Unit
    [Control_Unit.brd, Control_Unit.sch, ui_board.brd, ui_board.sch]
2018-12-26 suport .include command in assembler
    [Control_Unit.brd, Control_Unit.sch]
2018-12-27 throw error on duplicate .defines
    [assembler.c, math.asm]
2018-12-30 expand lib with uart_println
2019-09-12 add some files
    [io_board.brd, io_board.sch]
